alex-khoroshko/rohl/README.md

# Reef open hardware light
This is a project of open source / open hardware reef light. Current stage of development - proof of concept.
