alex-khoroshko/rohl/hardware/models/fcstd/battery_holder.fcstd

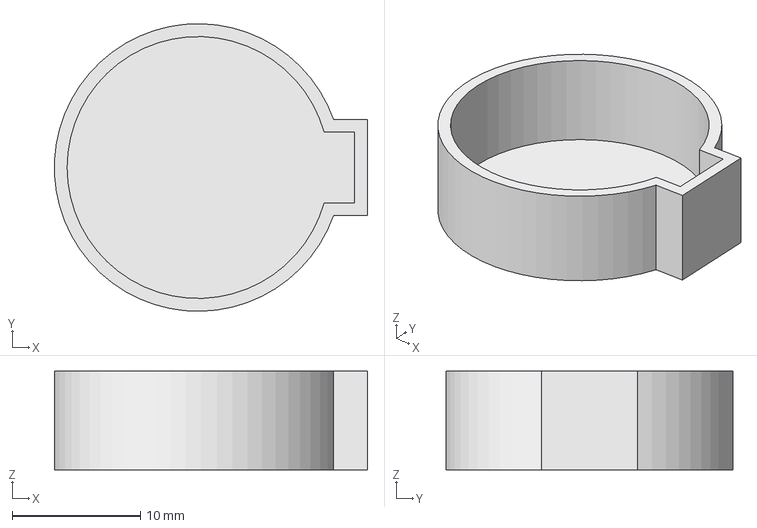
[picture p1: CAD file, 2018-11-22]
hardware/models/fcstd/battery_holder.fcstd
24.4 x 22.4 x 7.70 mm
