alex-khoroshko/rohl/hardware/models/led/xpe.fcstd

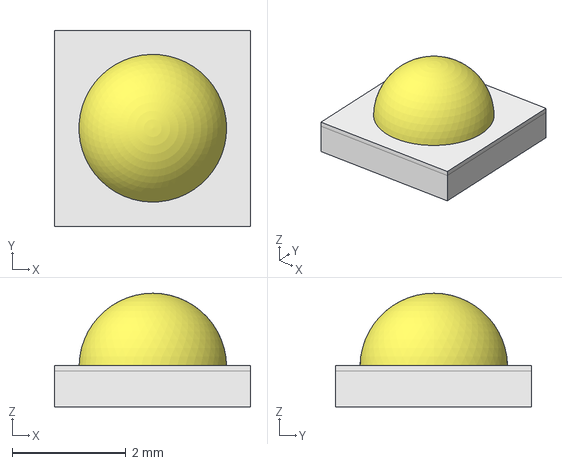
[picture p2: CAD file, 2018-11-19]
hardware/models/led/xpe.fcstd
3.45 x 3.45 x 2.00 mm
