alex-khoroshko/rohl/hardware/models/fcstd/connector_6x2.fcstd

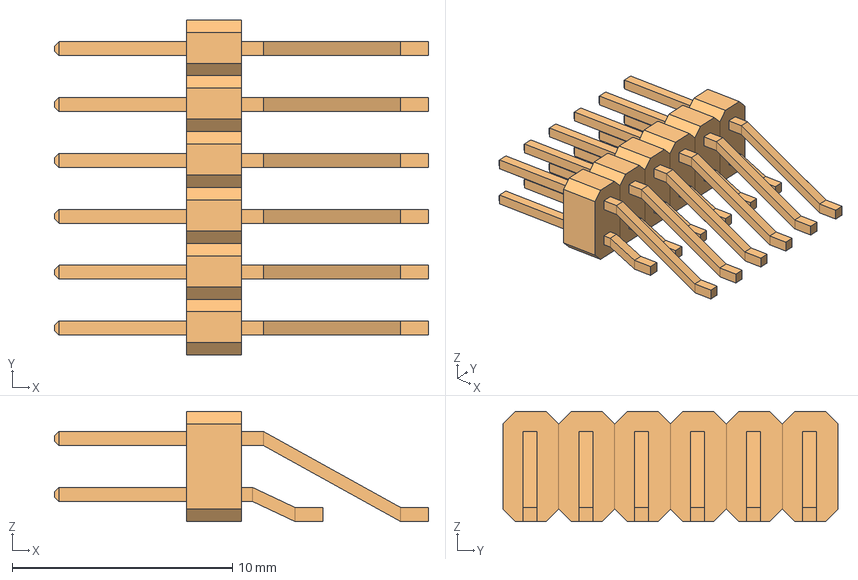
[picture p3: CAD file, 2018-11-22]
hardware/models/fcstd/connector_6x2.fcstd
17.0 x 15.2 x 5.00 mm
