alex-khoroshko/rohl/hardware/models/fcstd/esp32-wroom.fcstd

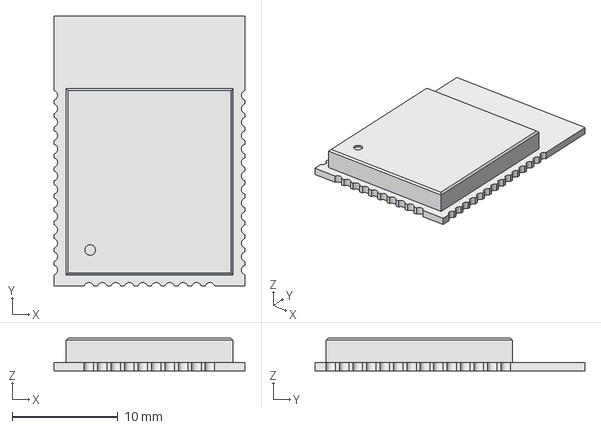
[picture p4: CAD file, 2018-11-22]
hardware/models/fcstd/esp32-wroom.fcstd
18.0 x 25.5 x 3.10 mm
