alex-khoroshko/rohl/hardware/models/fcstd/ms621fe.fcstd

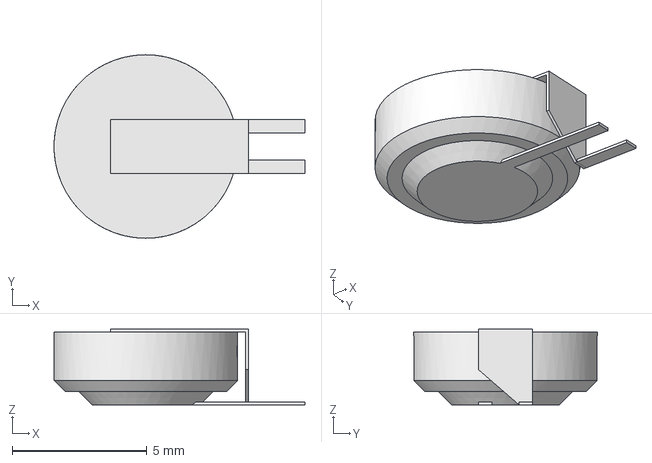
[picture p5: CAD file, 2018-11-22]
hardware/models/fcstd/ms621fe.fcstd
9.30 x 6.80 x 2.80 mm
