alex-khoroshko/rohl/hardware/models/fcstd/connector_5x2.fcstd

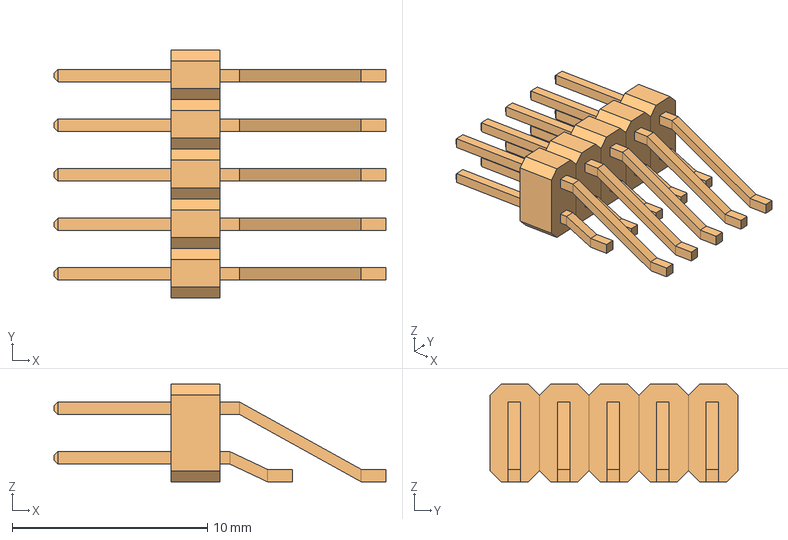
[picture p6: CAD file, 2018-11-19]
hardware/models/fcstd/connector_5x2.fcstd
17.0 x 12.7 x 5.00 mm
