alex-khoroshko/rohl/hardware/controller/controller.kicad_pcb

## KiCad design hardware/controller/controller.kicad_pcb (2018-11-26)

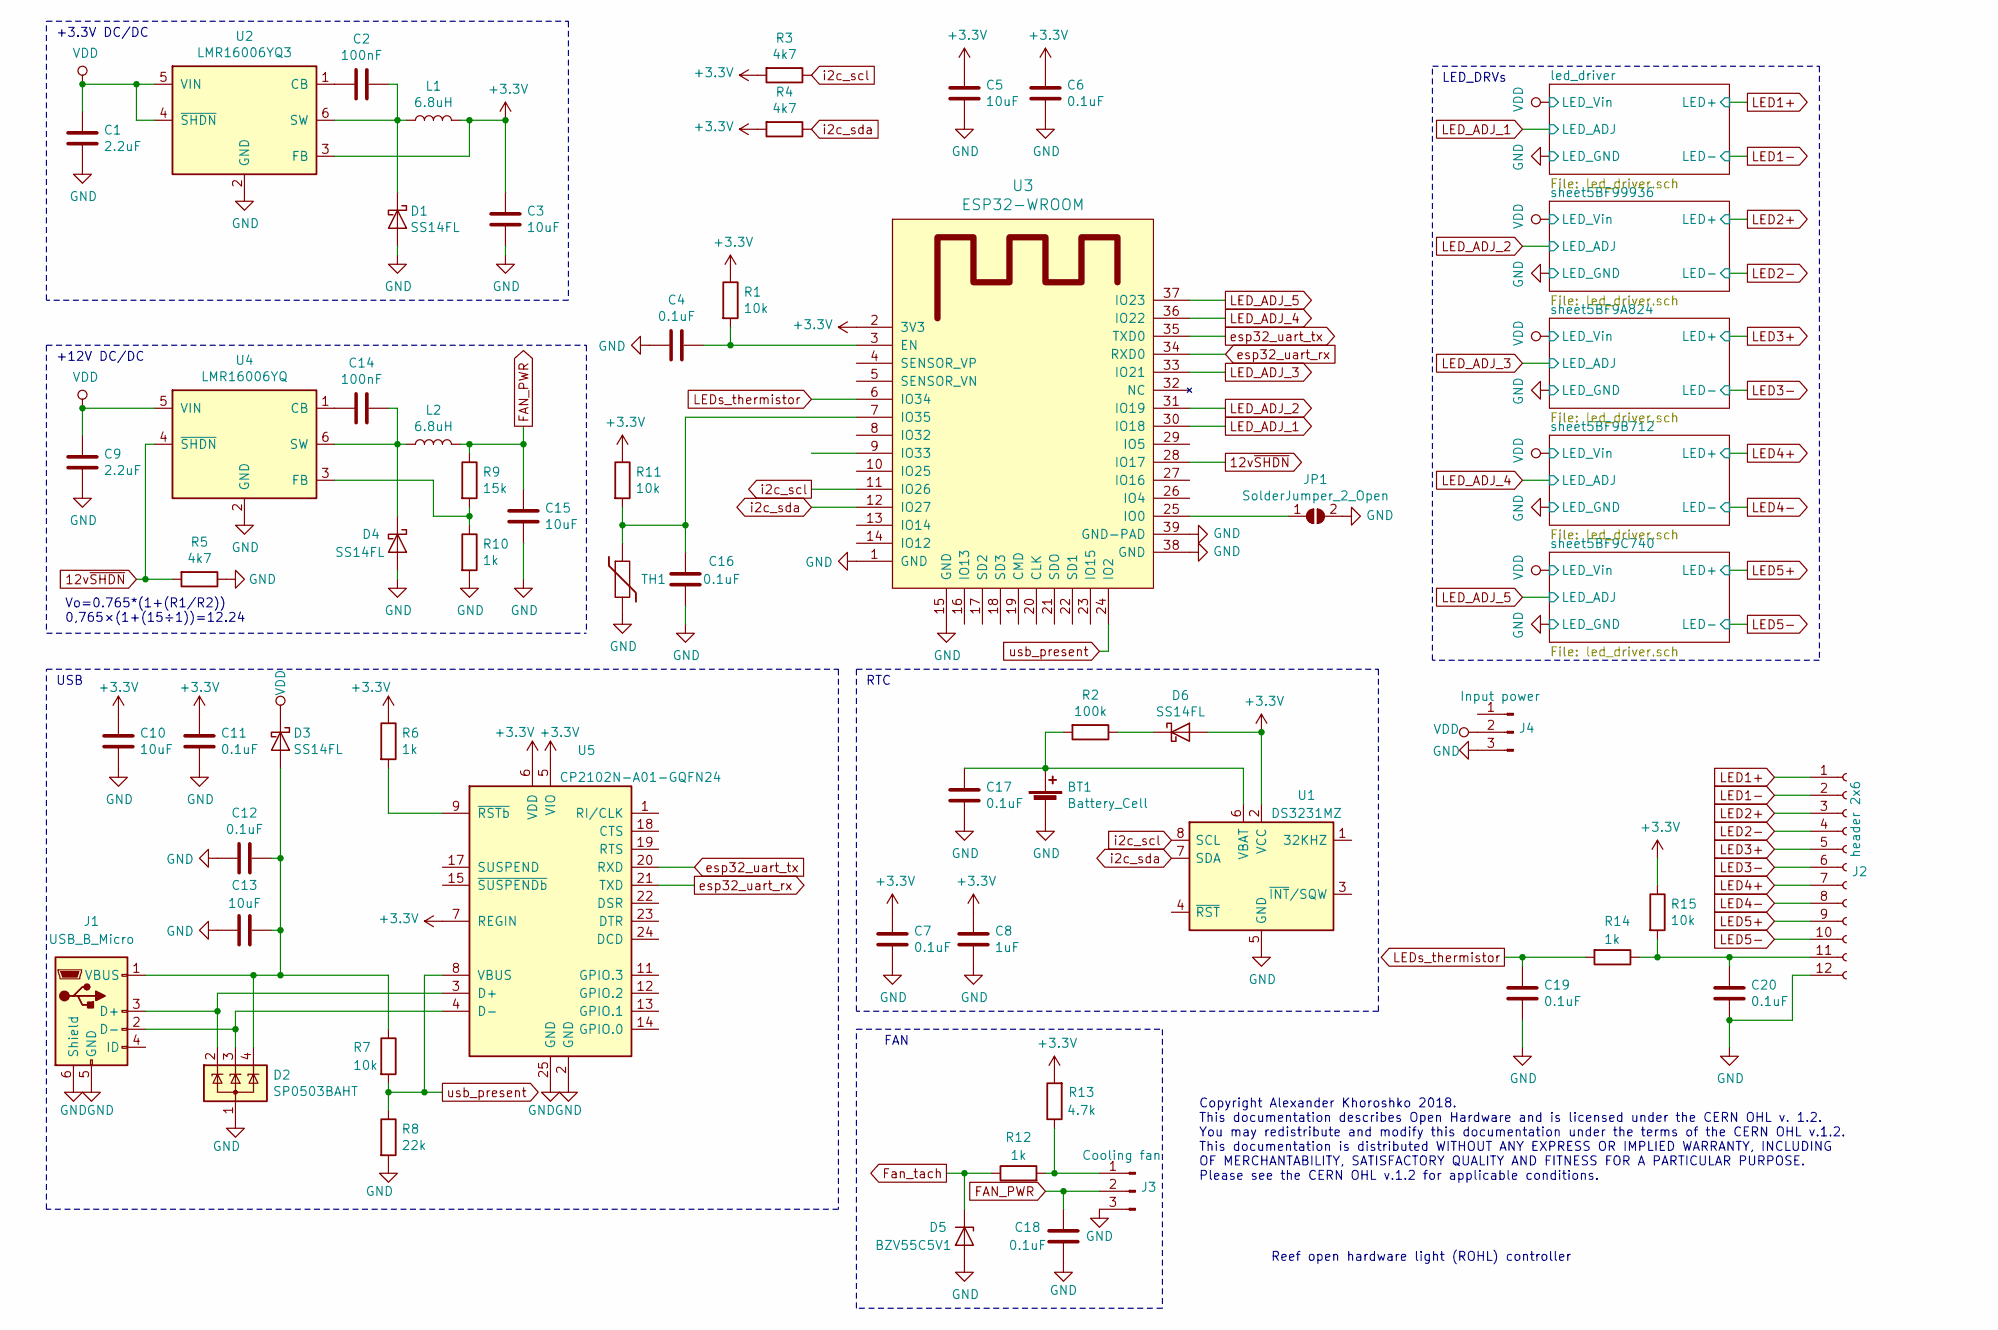
[picture p7: schematic controller.sch]

Parts:
BT1: Battery_Cell; MS621FE-FL11E
C1, C9: 2.2uF; C_0603_1608Metric_Pad1.05x0.95mm_HandSolder
C2, C14: 100nF; C_0603_1608Metric_Pad1.05x0.95mm_HandSolder
C3, C5, C10, C13, C15: 10uF; C_0603_1608Metric_Pad1.05x0.95mm_HandSolder
C4, C6, C7, C11, C12, C16, C17, C18, C19, C20: 0.1uF; C_0603_1608Metric_Pad1.05x0.95mm_HandSolder
C8: 1uF; C_0603_1608Metric_Pad1.05x0.95mm_HandSolder
D1, D3, D4, D6: SS14FL; D_SOD-123F
D2: SP0503BAHT; SOT-143
D5: BZV55C5V1; D_MiniMELF
J1: USB_B_Micro; USB_Micro-B_Molex-105017-0001
J2: header 2x6; PinHeader_2x06_P2.54mm_Vertical
J3: Cooling fan; FanPinHeader_1x03_P2.54mm_Vertical
J4: Input power; FanPinHeader_1x03_P2.54mm_Vertical
JP1: SolderJumper_2_Open; SolderJumper-2_P1.3mm_Open_TrianglePad1.0x1.5mm
L1, L2: 6.8uH; L_Wuerth_MAPI-3015
R1, R7, R11, R15: 10k; R_0603_1608Metric_Pad1.05x0.95mm_HandSolder
R2: 100k; R_0603_1608Metric_Pad1.05x0.95mm_HandSolder
R3, R4, R5: 4k7; R_0603_1608Metric_Pad1.05x0.95mm_HandSolder
R6, R10, R12, R14: 1k; R_0603_1608Metric_Pad1.05x0.95mm_HandSolder
R8: 22k; R_0603_1608Metric_Pad1.05x0.95mm_HandSolder
R9: 15k; R_0603_1608Metric_Pad1.05x0.95mm_HandSolder
R13: 4.7k; R_0603_1608Metric_Pad1.05x0.95mm_HandSolder
TH1: NTCS0603E3103; R_0603_1608Metric_Pad1.05x0.95mm_HandSolder
U1: DS3231MZ; SOIC-8_3.9x4.9mm_P1.27mm
U2: LMR16006YQ3; SOT-23-6
U3: ESP32-WROOM
U4: LMR16006YQ; SOT-23-6
U5: CP2102N-A01-GQFN24; QFN-24-1EP_4x4mm_P0.5mm_EP2.6x2.6mm

Connections:
12v~SHDN: R5.2, U3.28 (IO17), U4.4 (~SHDN)
+3V3: C3.1, C5.1, C6.2, C7.2, C8.2, C10.1, C11.2, D6.2 (A), L1.2, R1.1, R3.2, R4.2, R6.1, R11.1, R13.2, R15.1, U1.2 (VCC), U2.3 (FB), U3.2 (3V3), U5.5 (VIO), U5.6 (VDD), U5.7 (REGIN)
FAN_PWR: C15.1, C18.2, J3.2, L2.2, R9.1
Fan_tach: D5.1 (K), R12.1
GND: BT1.2 (-), C1.2, C3.2, C4.2, C5.2, C6.1, C7.1, C8.1, C9.2, C10.2, C11.1, C12.1, C13.2, C15.2, C16.1, C17.1, C18.1, C19.1, C20.1, D1.2 (A), D2.1 (A), D4.2 (A), D5.2 (A), J1.5 (GND), J1.6 (Shield), J2.12, J3.3, J4.3, JP1.2 (B), R5.1, R8.2, R10.2, TH1.2, U1.5 (GND), U2.2 (GND), U3.1 (GND), U3.15 (GND), U3.38 (GND), U3.39 (GND-PAD), U4.2 (GND), U5.2 (GND), U5.25 (GND); also elsewhere on the board
LED1+: J2.1; also elsewhere on the board
LED1-: J2.2; also elsewhere on the board
LED2+: J2.3; also elsewhere on the board
LED2-: J2.4; also elsewhere on the board
LED3+: J2.5; also elsewhere on the board
LED3-: J2.6; also elsewhere on the board
LED4+: J2.7; also elsewhere on the board
LED4-: J2.8; also elsewhere on the board
LED5+: J2.9; also elsewhere on the board
LED5-: J2.10; also elsewhere on the board
LED_ADJ_1: U3.30 (IO18); also elsewhere on the board
LED_ADJ_2: U3.31 (IO19); also elsewhere on the board
LED_ADJ_3: U3.33 (IO21); also elsewhere on the board
LED_ADJ_4: U3.36 (IO22); also elsewhere on the board
LED_ADJ_5: U3.37 (IO23); also elsewhere on the board
LEDs_thermistor: C19.2, R14.2, U3.6 (IO34)
unnamed: BT1.1 (+), C17.2, R2.2, U1.6 (VBAT)
unnamed: C2.1, D1.1 (K), L1.1, U2.6 (SW)
unnamed: C2.2, U2.1 (CB)
unnamed: C4.1, R1.2, U3.3 (EN)
unnamed: C12.2, C13.1, D2.4 (K), D3.2 (A), J1.1 (VBUS), R7.1
unnamed: C14.1, D4.1 (K), L2.1, U4.6 (SW)
unnamed: C14.2, U4.1 (CB)
unnamed: C16.2, R11.2, TH1.1, U3.7 (IO35)
unnamed: C20.2, J2.11, R14.1, R15.2
unnamed: D2.2 (K), J1.3 (D+), U5.3 (D+)
unnamed: D2.3 (K), J1.2 (D-), U5.4 (D-)
unnamed: D6.1 (K), R2.1
unnamed: J3.1, R12.2, R13.1
unnamed: JP1.1 (A), U3.25 (IO0)
unnamed: R6.2, U5.9 (~RSTb)
unnamed: R9.2, R10.1, U4.3 (FB)
VDD: C1.1, C9.1, D3.1 (K), J4.2, U2.4 (~SHDN), U2.5 (VIN), U4.5 (VIN); also elsewhere on the board
esp32_uart_rx: U3.34 (RXD0), U5.21 (TXD)
esp32_uart_tx: U3.35 (TXD0), U5.20 (RXD)
i2c_scl: R3.1, U1.8 (SCL), U3.11 (IO26)
i2c_sda: R4.1, U1.7 (SDA), U3.12 (IO27)
usb_present: R7.2, R8.1, U3.24 (IO2), U5.8 (VBUS)

Notes on the sheet:
RTC
+3.3V DC/DC
USB
LED_DRVs
+12V DC/DC
FAN
Vo=0.765*(1+(R1/R2)) 0,765×(1+(15÷1))=12.24
Copyright Alexander Khoroshko 2018. This documentation describes Open Hardware and is licensed under the CERN OHL v. 1.2. You may redistribute and modify this documentation under the terms of the CERN OHL v.1.2. This documentation is distributed WITHOUT ANY EXPRESS OR IMPLIED WARRANTY, INCLUDING OF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
Reef open hardware light (ROHL) controller

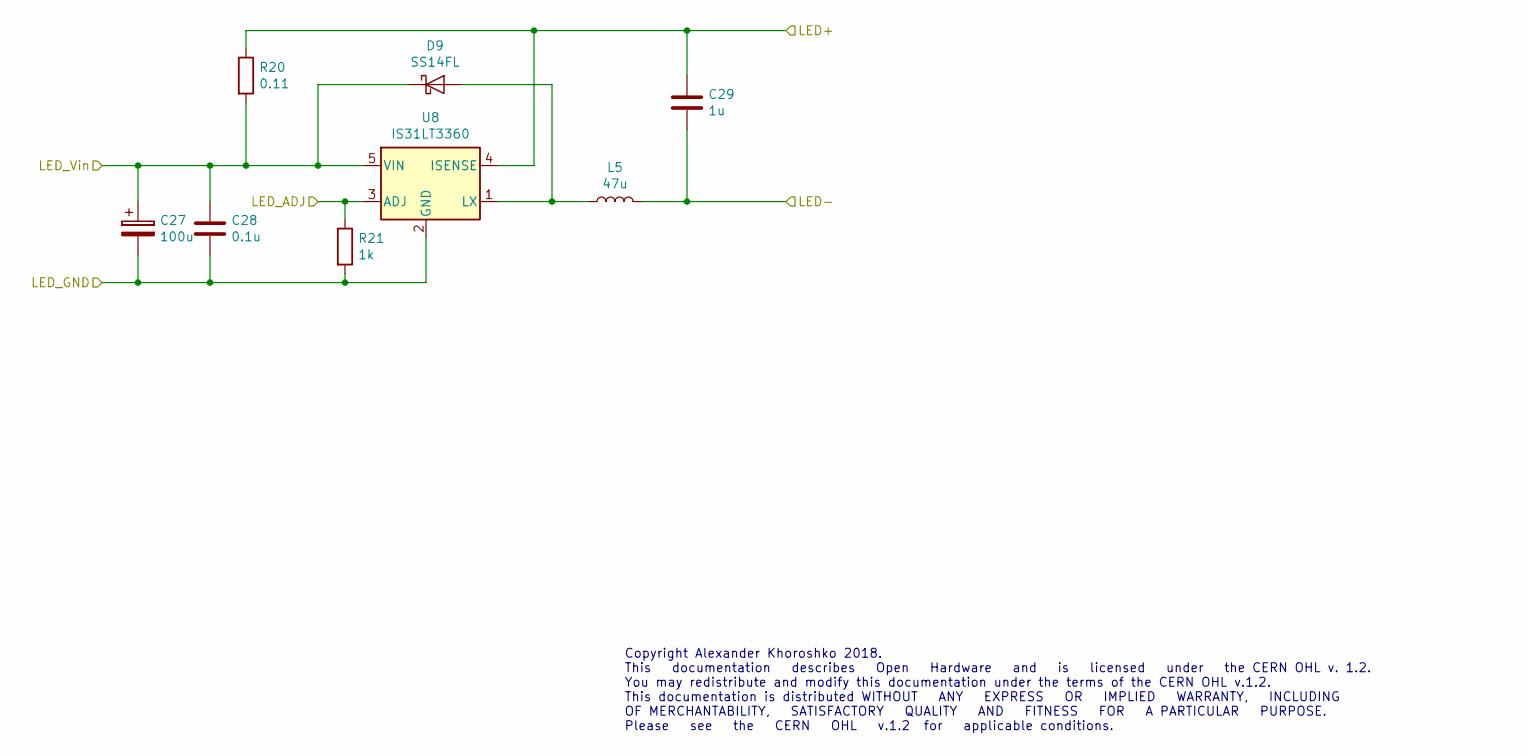
[picture p8: schematic led_driver.sch]

Parts:
C21: 100u; CP_Elec_10x7.9
C22: 0.1u; C_0603_1608Metric_Pad1.05x0.95mm_HandSolder
C23: 1u; C_0603_1608Metric_Pad1.05x0.95mm_HandSolder
D7: SS14FL; D_SOD-123F
L3: 47u; L_12x12mm_H6mm
R16: 0.11; R_0805_2012Metric_Pad1.15x1.40mm_HandSolder
R17: 1k; R_0603_1608Metric_Pad1.05x0.95mm_HandSolder
U6: IS31LT3360; SOT-89-5

Connections:
GND: C21.2, C22.2, R17.2, U6.2 (GND); also elsewhere on the board
LED1+: C23.1, R16.1, U6.4 (ISENSE); also elsewhere on the board
LED1-: C23.2, L3.2; also elsewhere on the board
LED_ADJ_1: R17.1, U6.3 (ADJ); also elsewhere on the board
unnamed: D7.2 (A), L3.1, U6.1 (LX)
VDD: C21.1, C22.1, D7.1 (K), R16.2, U6.5 (VIN); also elsewhere on the board

Parts of its further copies:
C24, C27, C30, C33: 100u; CP_Elec_10x7.9
C25, C28, C31, C34: 0.1u; C_0603_1608Metric_Pad1.05x0.95mm_HandSolder
C26, C29, C32, C35: 1u; C_0603_1608Metric_Pad1.05x0.95mm_HandSolder
D8, D9, D10, D11: SS14FL; D_SOD-123F
L4, L5, L6, L7: 47u; L_12x12mm_H6mm
R18, R20, R22, R24: 0.11; R_0805_2012Metric_Pad1.15x1.40mm_HandSolder
R19, R21, R23, R25: 1k; R_0603_1608Metric_Pad1.05x0.95mm_HandSolder
U7, U8, U9, U10: IS31LT3360; SOT-89-5

Connections of its further copies:
GND: C24.2, C25.2, C27.2, C28.2, C30.2, C31.2, C33.2, C34.2, R19.2, R21.2, R23.2, R25.2, U7.2 (GND), U8.2 (GND), U9.2 (GND), U10.2 (GND); also elsewhere on the board
LED2+: C26.1, R18.1, U7.4 (ISENSE); also elsewhere on the board
LED2-: C26.2, L4.2; also elsewhere on the board
LED3+: C29.1, R20.1, U8.4 (ISENSE); also elsewhere on the board
LED3-: C29.2, L5.2; also elsewhere on the board
LED4+: C32.1, R22.1, U9.4 (ISENSE); also elsewhere on the board
LED4-: C32.2, L6.2; also elsewhere on the board
LED5+: C35.1, R24.1, U10.4 (ISENSE); also elsewhere on the board
LED5-: C35.2, L7.2; also elsewhere on the board
LED_ADJ_2: R19.1, U7.3 (ADJ); also elsewhere on the board
LED_ADJ_3: R21.1, U8.3 (ADJ); also elsewhere on the board
LED_ADJ_4: R23.1, U9.3 (ADJ); also elsewhere on the board
LED_ADJ_5: R25.1, U10.3 (ADJ); also elsewhere on the board
unnamed: D8.2 (A), L4.1, U7.1 (LX)
unnamed: D9.2 (A), L5.1, U8.1 (LX)
unnamed: D10.2 (A), L6.1, U9.1 (LX)
unnamed: D11.2 (A), L7.1, U10.1 (LX)
VDD: C24.1, C25.1, C27.1, C28.1, C30.1, C31.1, C33.1, C34.1, D8.1 (K), D9.1 (K), D10.1 (K), D11.1 (K), R18.2, R20.2, R22.2, R24.2, U7.5 (VIN), U8.5 (VIN), U9.5 (VIN), U10.5 (VIN); also elsewhere on the board

Notes on the sheet:
Copyright Alexander Khoroshko 2018. This documentation describes Open Hardware and is licensed under the CERN OHL v. 1.2. You may redistribute and modify this documentation under the terms of the CERN OHL v.1.2. This documentation is distributed WITHOUT ANY EXPRESS OR IMPLIED WARRANTY, INCLUDING OF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

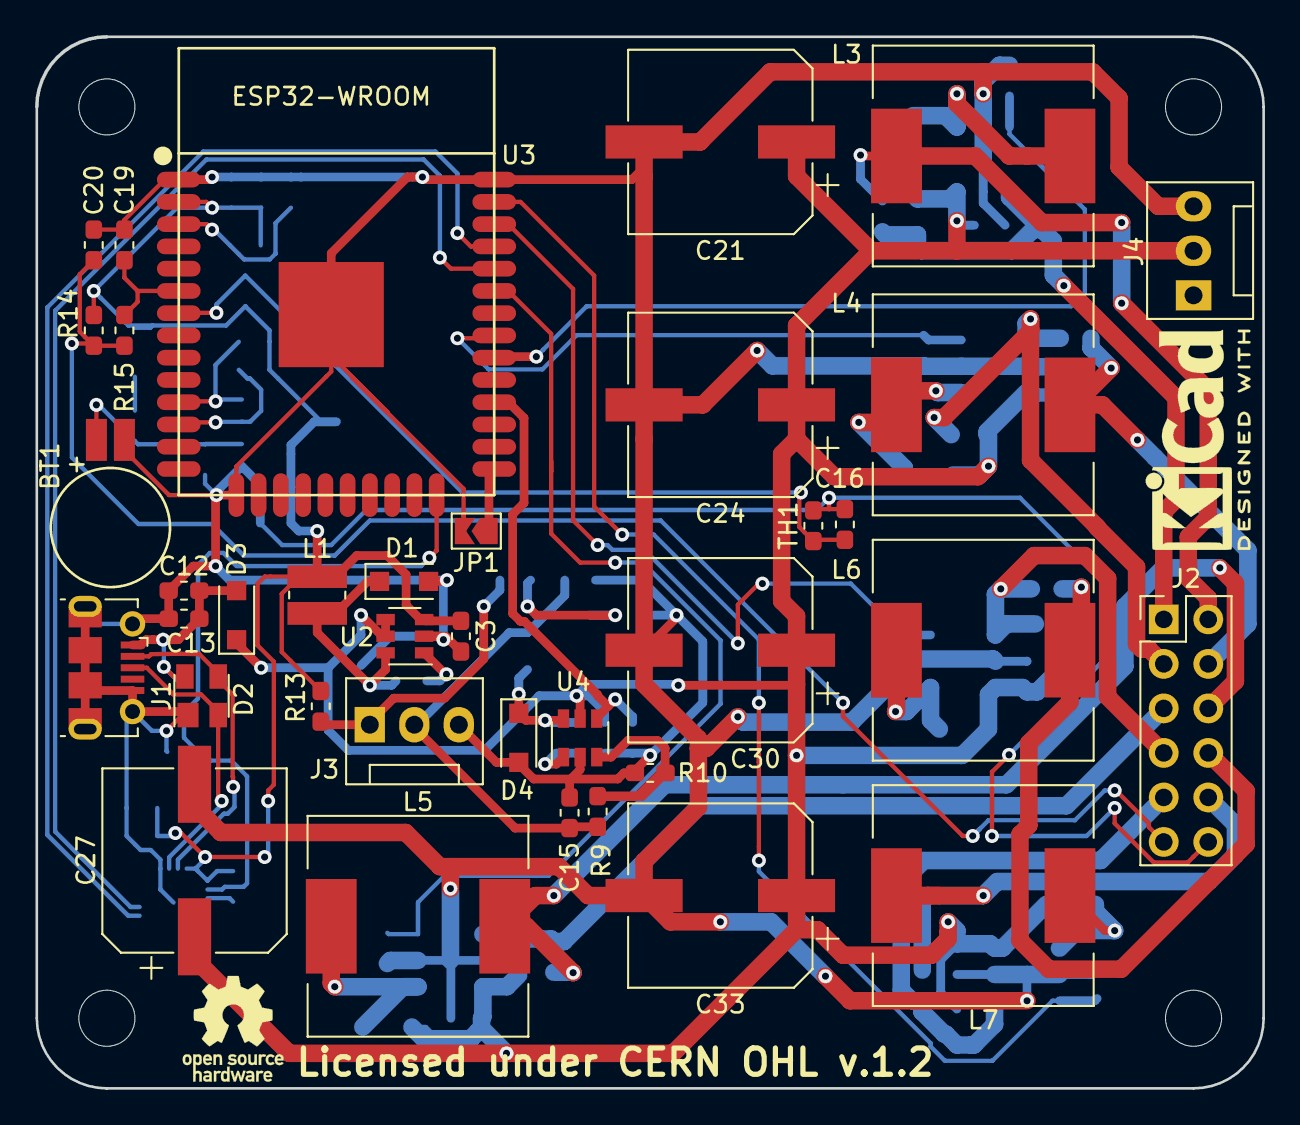
[picture p9: board controller.kicad_pcb from above]

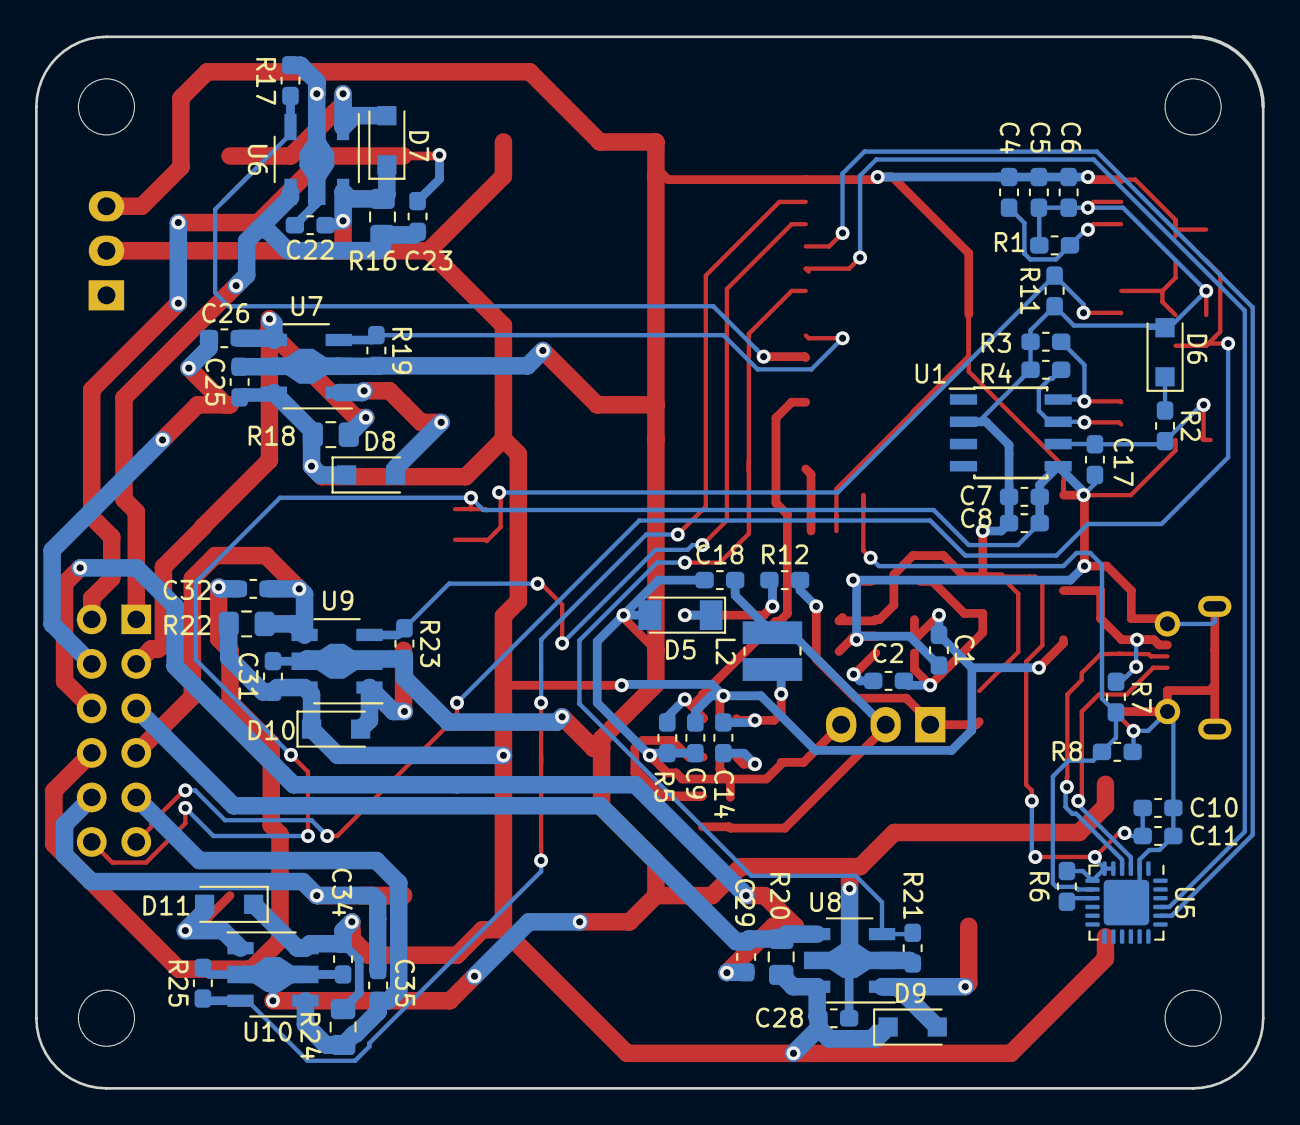
[picture p10: board controller.kicad_pcb from below]

Board: 2 copper layers, 70.0 x 60.0 mm, 95 parts (58 on the bottom side), 48 nets.
