alex-khoroshko/rohl/hardware/led_array/25led_array_CH100W/xpe_25pcs.kicad_pcb

## KiCad design hardware/led_array/25led_array_CH100W/xpe_25pcs.kicad_pcb (2018-11-26)

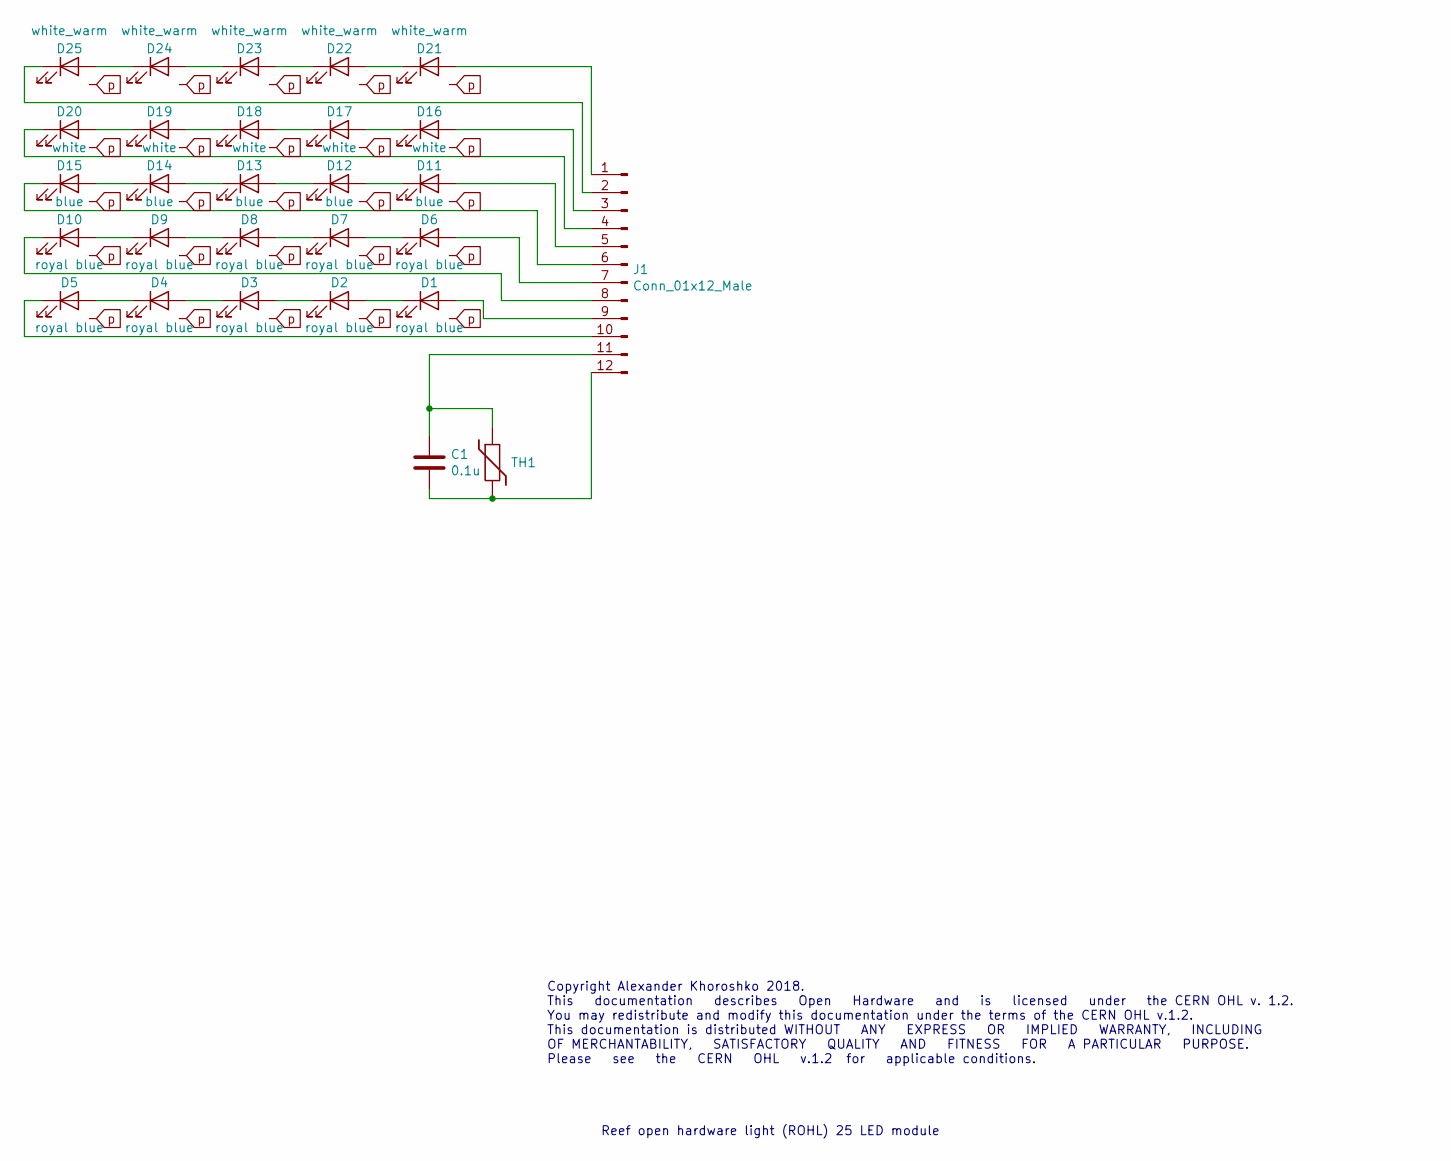
[picture p11: schematic xpe_25pcs.sch]

Parts:
C1: 0.1u; C_0603_1608Metric_Pad1.05x0.95mm_HandSolder
D1, D2, D3, D4, D5, D6, D7, D8, D9, D10: royal blue; LED_Cree-XP-E_vias
D11, D12, D13, D14, D15: blue; LED_Cree-XP-E_vias
D16, D17, D18, D19, D20: white; LED_Cree-XP-E_vias
D21, D22, D23, D24, D25: white_warm; LED_Cree-XP-E_vias
J1: Conn_01x12_Male; header_12_smd
TH1: NTCS0603E3103; C_0603_1608Metric_Pad1.05x0.95mm_HandSolder

Connections:
unnamed: C1.1, J1.11, TH1.1
unnamed: C1.2, J1.12, TH1.2
unnamed: D1.1 (K), D2.2 (A)
unnamed: D1.2 (A), J1.9
unnamed: D2.1 (K), D3.2 (A)
unnamed: D3.1 (K), D4.2 (A)
unnamed: D4.1 (K), D5.2 (A)
unnamed: D5.1 (K), J1.10
unnamed: D6.1 (K), D7.2 (A)
unnamed: D6.2 (A), J1.7
unnamed: D7.1 (K), D8.2 (A)
unnamed: D8.1 (K), D9.2 (A)
unnamed: D10.1 (K), J1.8
unnamed: D9.1 (K), D10.2 (A)
unnamed: D11.1 (K), D12.2 (A)
unnamed: D11.2 (A), J1.5
unnamed: D12.1 (K), D13.2 (A)
unnamed: D13.1 (K), D14.2 (A)
unnamed: D14.1 (K), D15.2 (A)
unnamed: D15.1 (K), J1.6
unnamed: D16.1 (K), D17.2 (A)
unnamed: D16.2 (A), J1.3
unnamed: D17.1 (K), D18.2 (A)
unnamed: D18.1 (K), D19.2 (A)
unnamed: D19.1 (K), D20.2 (A)
unnamed: D20.1 (K), J1.4
unnamed: D21.1 (K), D22.2 (A)
unnamed: D21.2 (A), J1.1
unnamed: D22.1 (K), D23.2 (A)
unnamed: D23.1 (K), D24.2 (A)
unnamed: D24.1 (K), D25.2 (A)
unnamed: D25.1 (K), J1.2
p: D1.3 (pad), D2.3 (pad), D3.3 (pad), D4.3 (pad), D5.3 (pad), D6.3 (pad), D7.3 (pad), D8.3 (pad), D9.3 (pad), D10.3 (pad), D11.3 (pad), D12.3 (pad), D13.3 (pad), D14.3 (pad), D15.3 (pad), D16.3 (pad), D17.3 (pad), D18.3 (pad), D19.3 (pad), D20.3 (pad), D21.3 (pad), D22.3 (pad), D23.3 (pad), D24.3 (pad), D25.3 (pad)

Notes on the sheet:
Copyright Alexander Khoroshko 2018. This documentation describes Open Hardware and is licensed under the CERN OHL v. 1.2. You may redistribute and modify this documentation under the terms of the CERN OHL v.1.2. This documentation is distributed WITHOUT ANY EXPRESS OR IMPLIED WARRANTY, INCLUDING OF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
Reef open hardware light (ROHL) 25 LED module

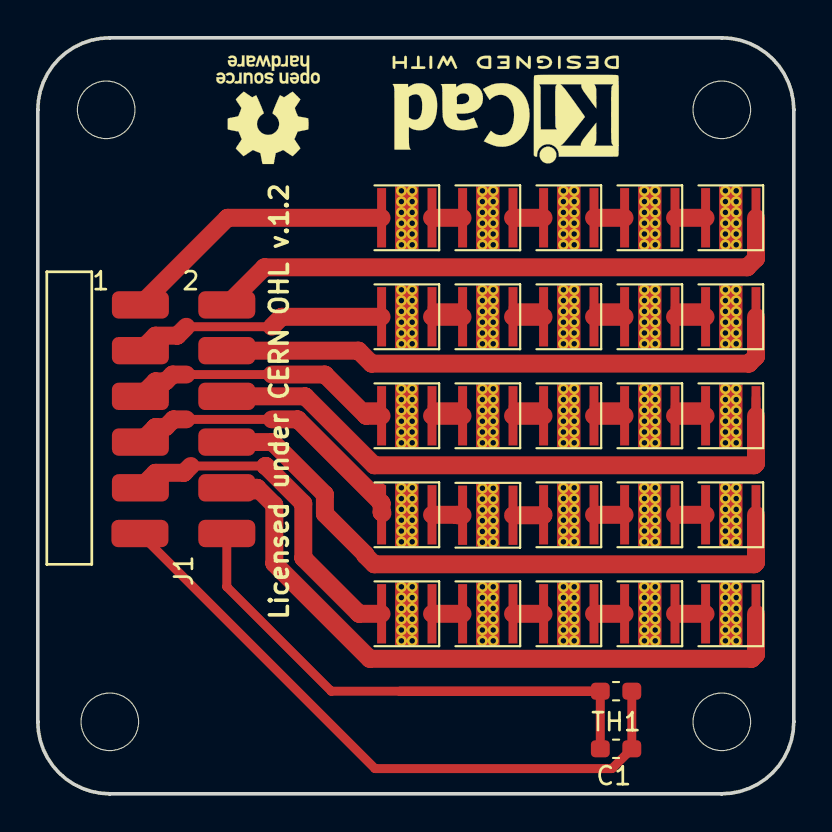
[picture p12: board xpe_25pcs.kicad_pcb from above]

Board: 2 copper layers, 42.0 x 42.0 mm, 28 parts (0 on the bottom side), 33 nets.
