alex-khoroshko/rohl/(commit log)

2018-11-19 developed led model and sch
    [xpe.fcstd, xpe.step, xpe_25pcs.kicad_pcb, xpe_25pcs.sch]
2018-11-19 initial 80mm pcb draft ready
    [connector_5x2.fcstd, xpe.step, xpe_25pcs-2018-11-19-10-04-03.sch, xpe_25pcs.kicad_pcb, xpe_25pcs.sch]
2018-11-19 25 led array improved
    [xpe_25pcs.kicad_pcb, xpe_25pcs.sch]
2018-11-19 folder name improvements
    [xpe_25pcs-2018-11-19-10-04-03.sch, xpe_25pcs.kicad_pcb, xpe_25pcs.sch]
2018-11-20 led 25 array rework (fix distance from 38 to 34mm, space between header and led added)
    [controller.kicad_pcb, controller.sch, xpe_25pcs.kicad_pcb]
2018-11-22 controller schematic draft finished
    [battery_holder.fcstd, connector_5x2.fcstd, connector_6x2.fcstd, controller.kicad_pcb, controller.sch, esp32-wroom.fcstd, led_driver.sch, ms621fe.fcstd]
2018-11-22 initial controller components placement
    [controller.kicad_pcb, controller.sch, led_driver.sch]
2018-11-22 open source hardware fix
    [controller.sch, led_driver.sch, xpe_25pcs.sch]
2018-11-23 controller partially traced
    [controller.kicad_pcb, controller.sch, led_driver.sch]
2018-11-26 led array rework for fr4 board
    [controller.kicad_pcb, xpe_25pcs.kicad_pcb, xpe_25pcs.sch]
2018-11-26 controller finished. Sent both boards for manufacturing
    [controller.kicad_pcb, controller.sch, led_driver.sch]
2018-12-05 software: current version uploads sliders values to server side
2019-01-13 time rework in progress
    [ajax.js]
2019-01-26 adc, pwm and file operation implemended. Tempr readout added to web
2019-01-26 temperature display works (visuals need revision)
2019-01-27 correct temperature viewing implemended
    [web_server.py]
2019-02-03 pwm fixed
