alex-khoroshko/rohl/(notices)

Notices in the files:
hardware/led_array/25led_array_CH100W/xpe_25pcs.kicad_pcb:
Licensed under CERN OHL v.1.2
